Mm-Fazlollahpour/Resonant-Wireless-Power-Transfer/Demosntration/README.md

# Hardware Demonstration

This directory contains a demonstration video of the **Resonant Wireless Power Transfer System**.

The demonstration illustrates short-range inductive energy transfer from a MOSFET-based transmitting circuit to a receiving coil, with a **DC motor** serving as the load.

## Demonstration Video

[**Watch the Wireless Power Transfer Demonstration**](Wireless_Power_Transfer_Demo.mp4)

For circuit operation and design details, refer to the [Hardware Documentation](../Hardware/) and the [Technical Report](../Report/Resonant_Wireless_Power_Transfer_Technical_Report.pdf).
