Mm-Fazlollahpour/Resonant-Wireless-Power-Transfer/Images/README.md

# Project Images

This directory contains visual documentation of the **Resonant Wireless Power Transfer System**, including the circuit schematic, PCB layout, 3D PCB visualization, and assembled hardware.

## Assembled Hardware Prototype

<p align="center">Assembled wireless power transfer prototype</p>
<p align="center"><em>Figure 1. Physical prototype for the wireless power transfer demonstration.</em></p>

## PCB 3D View

<p align="center">PCB 3D visualization</p>
<p align="center"><em>Figure 2. Three-dimensional PCB visualization.</em></p>

## Circuit Schematic

<p align="center">Wireless power transfer circuit schematic</p>
<p align="center"><em>Figure 3. Circuit schematic documenting the main functional blocks.</em></p>

## PCB Layout

<p align="center">Wireless power transfer PCB layout</p>
<p align="center"><em>Figure 4. Printed circuit board layout.</em></p>

For an explanation of the circuit and PCB, see the [Hardware Documentation](../Hardware/).
