Mm-Fazlollahpour/Resonant-Wireless-Power-Transfer/Images/Circuit_Schematic2.jpg

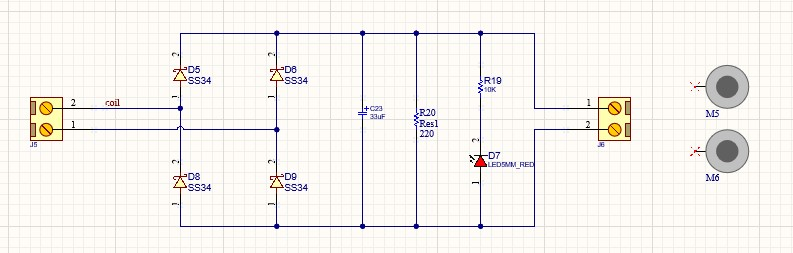
Images/Circuit_Schematic2.jpg
