Mm-Fazlollahpour/Resonant-Wireless-Power-Transfer/(list of files, drawings)

Other design files:
Hardware/PCB1.PcbDoc
Hardware/Sheet1.SchDoc
Hardware/Sheet2.SchDoc
